AdamProbert/ServoTester/RemodelledDial.png

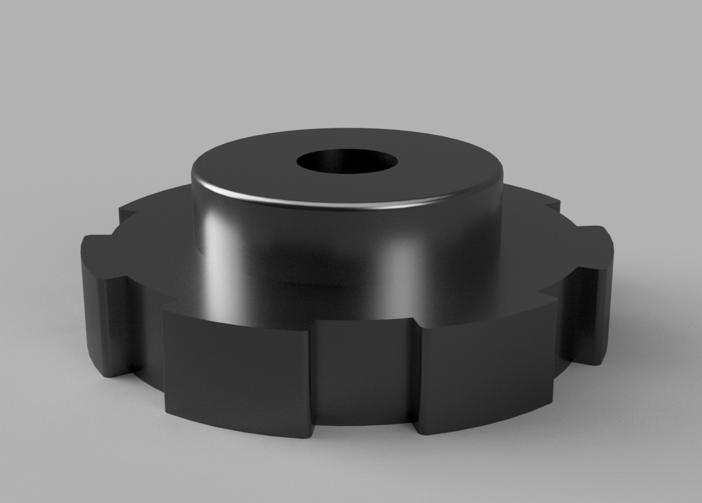
RemodelledDial.png
