AdamProbert/ServoTester/RemodelledDial.3mf

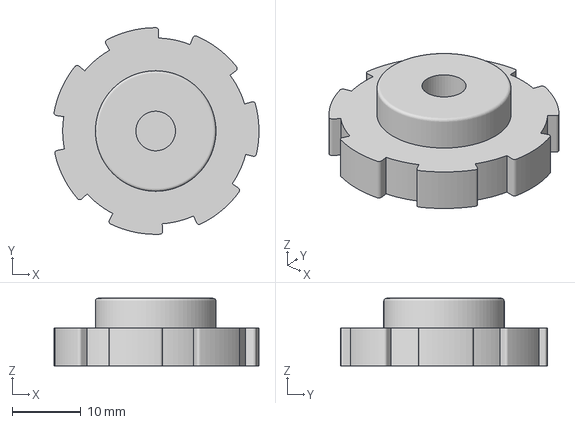
[picture p3: CAD file, 2025-09-16]
RemodelledDial.3mf
29.8 x 30.0 x 9.80 mm
