AdamProbert/ServoTester/(commit log)

2025-09-16 add servotester
2025-09-16 docs: populate readme
    [RemodelledDial.3mf]
